KnapskaLab/Current_Protocols/README.md

# Current_Protocols
This repository contains materials necessary to conduct Imminent Threat Paradigm in both contextual and auditory-cued variants
