KnapskaLab/Current_Protocols/Cage_schematics.pdf

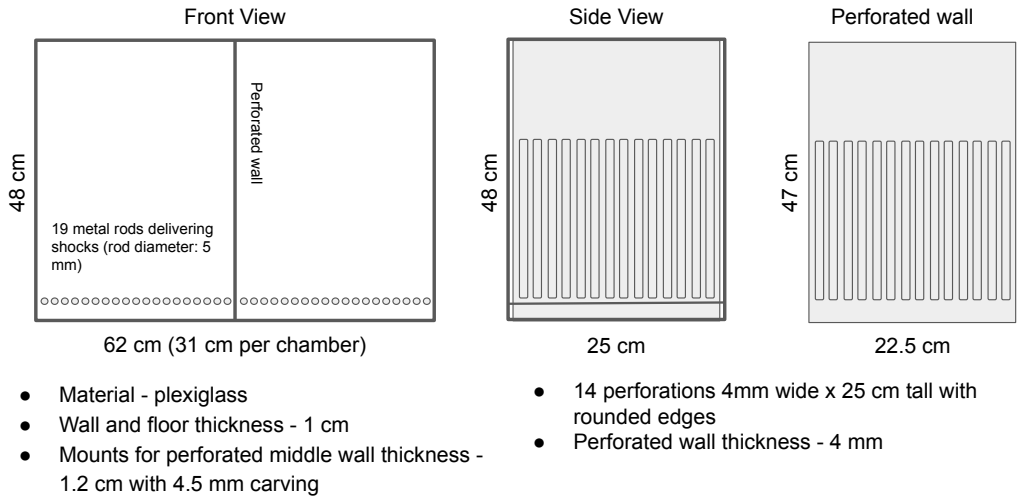
[picture p1: page 1]
Front View; Side View; Perforated wall

62 cm (31 cm per chamber) Perforated wall

19 metal rods delivering
shocks (rod diameter: 5

● Material - plexiglass
● Wall and floor thickness - 1 cm
● Mounts for perforated middle wall thickness -
1.2 cm with 4.5 mm carving

● 14 perforations 4mm wide x 25 cm tall with
rounded edges
● Perforated wall thickness - 4 mm
