KnapskaLab/Current_Protocols/PCB_Project/1_3_AURDINO_UNO.pdf

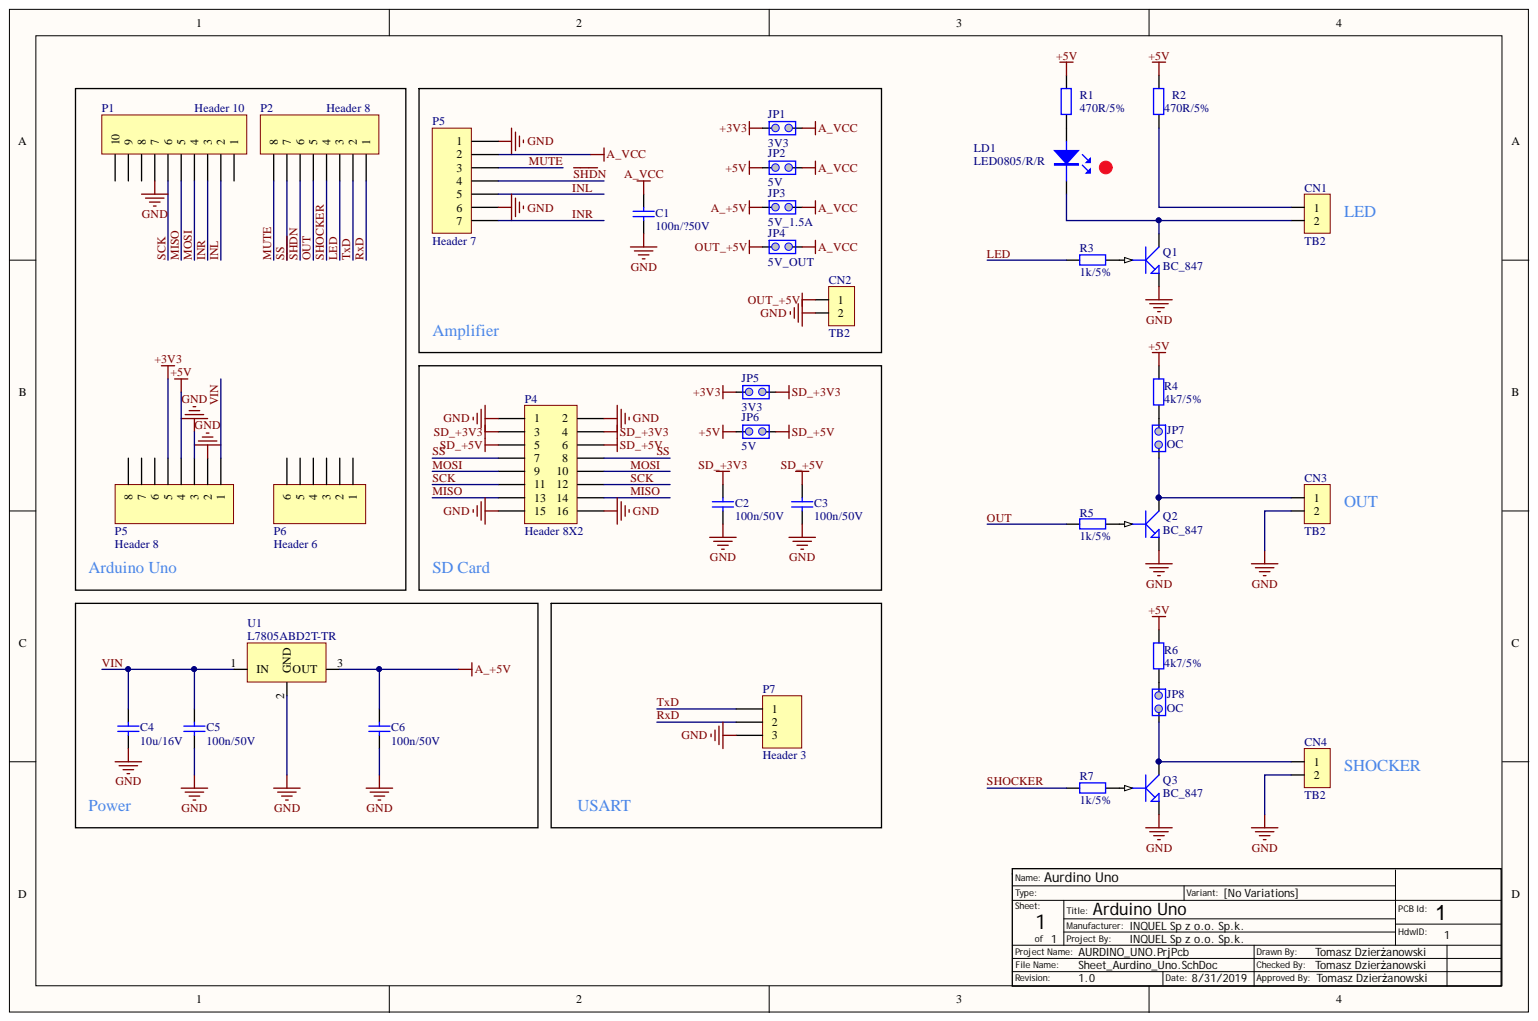
[picture p2: page 1]

T y p e : | t : [ No V ari a t ions]
Sh e e t :o 1 f 1 | PcbVarian Arduino Uno Title : | P CB Id : 1

AURDIN O _UN O . Prj Proj e c t Nam e : | Tom a sz Dz ier ż anowski Drawn By :
File Nam e : Sheet _Aurd ino_Uno. SchDoc | C h e c k e d By : Tom a sz Dz ier ż anowski
R e visio n : 1 . 0 | Dat e : 8 / 3 1 / 2 0 1 9 | A p pro v e d By : Tom a sz Dz ier ż anowski

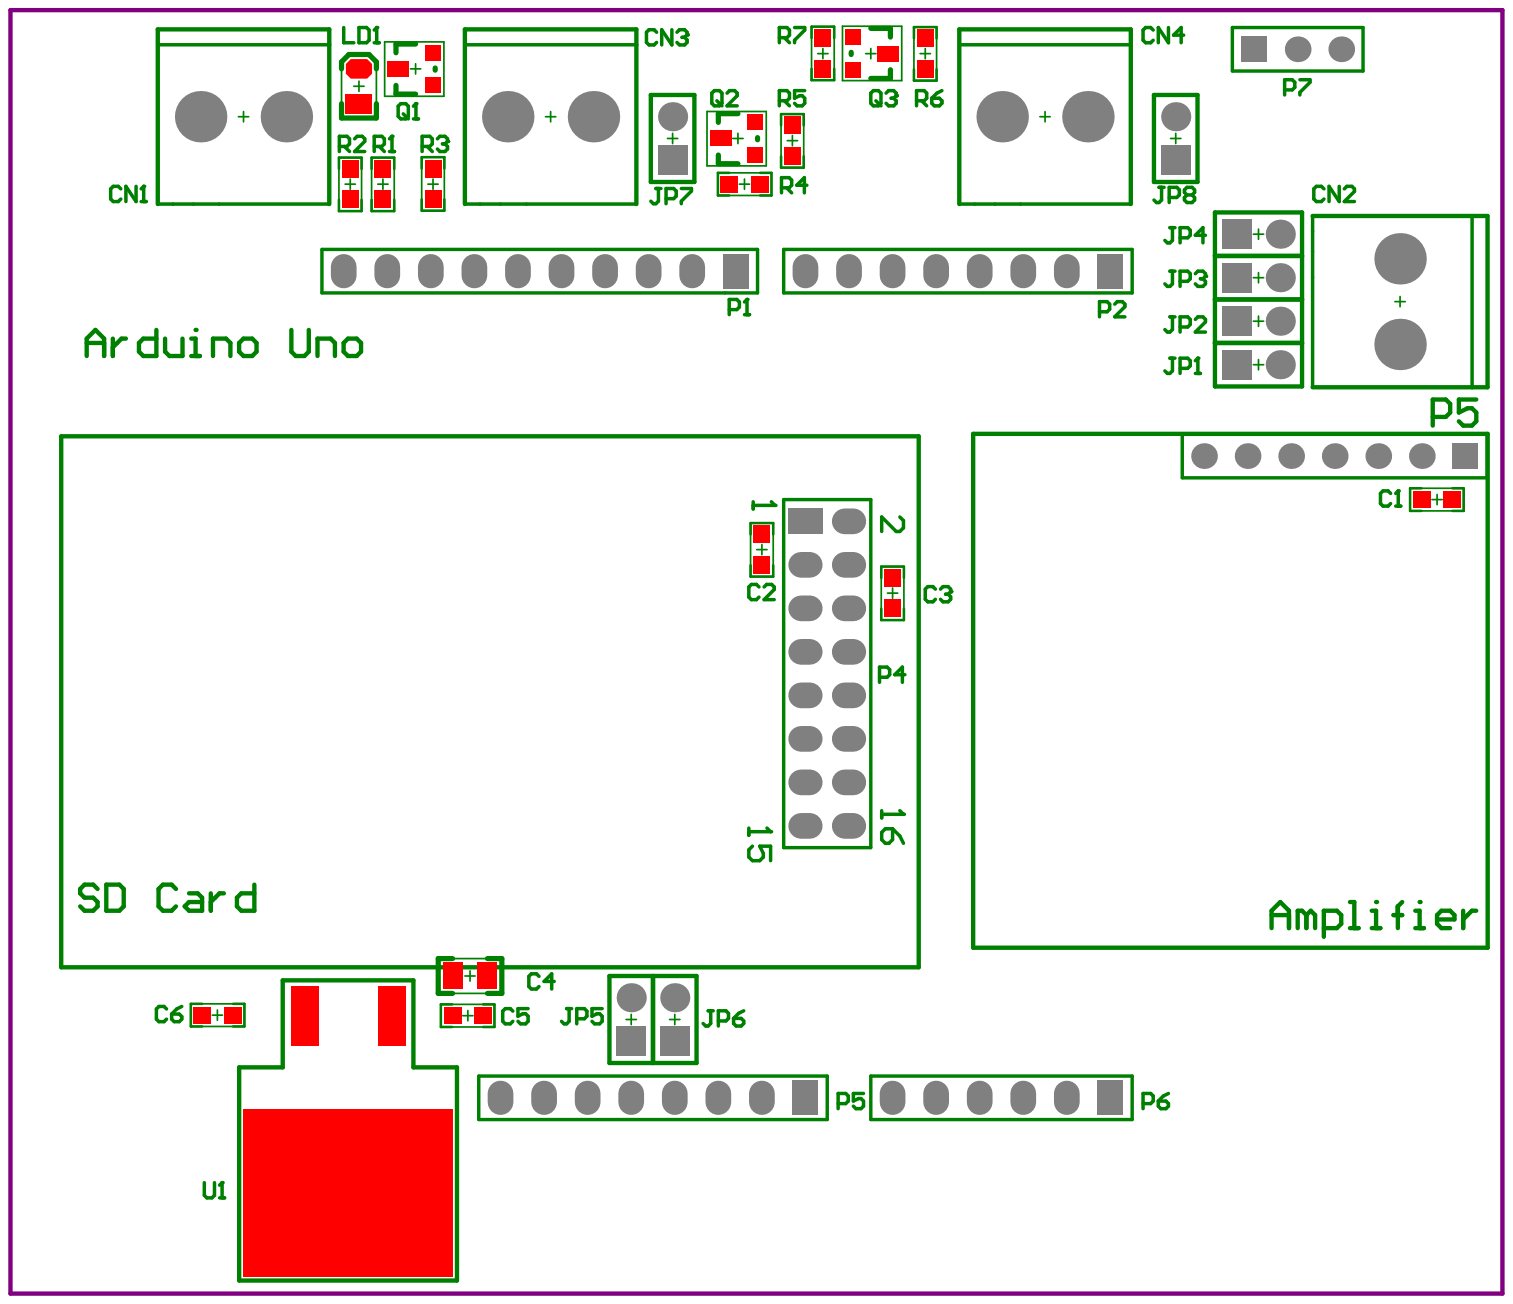
[picture p3: page 2]

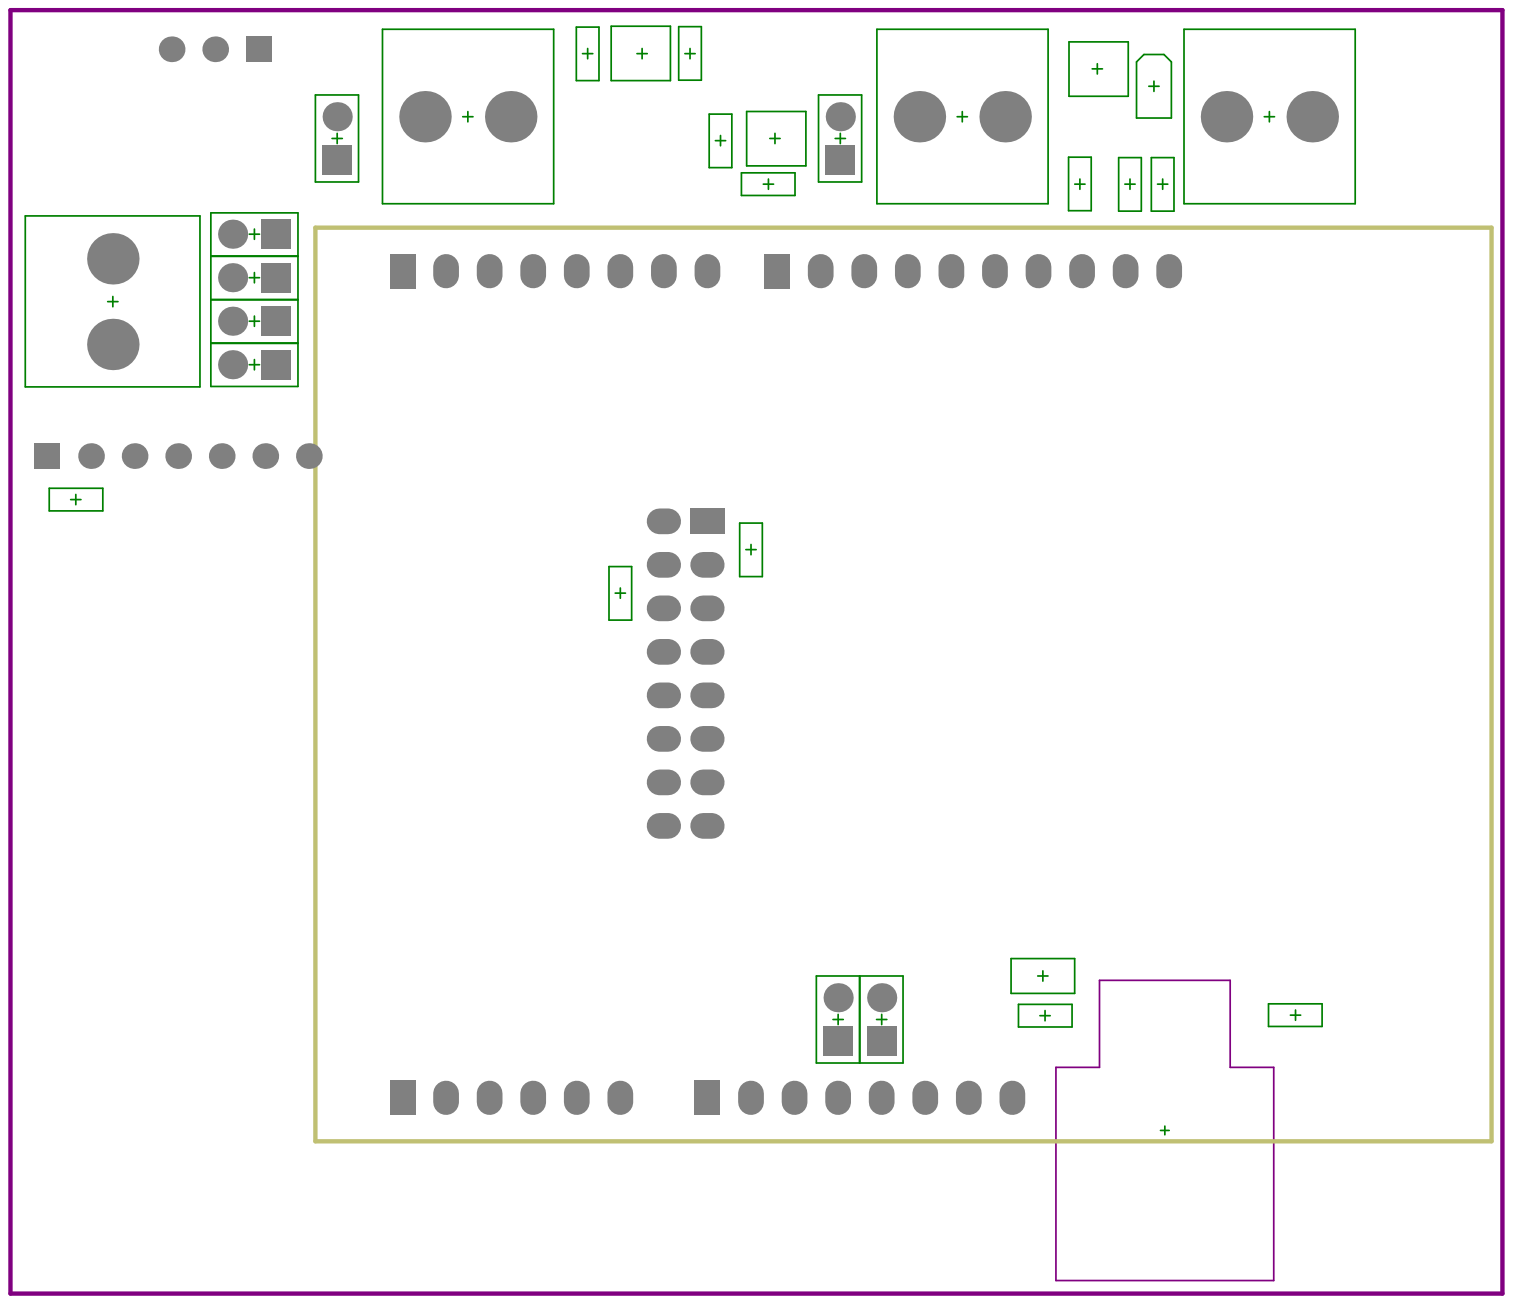
[picture p4: page 3]

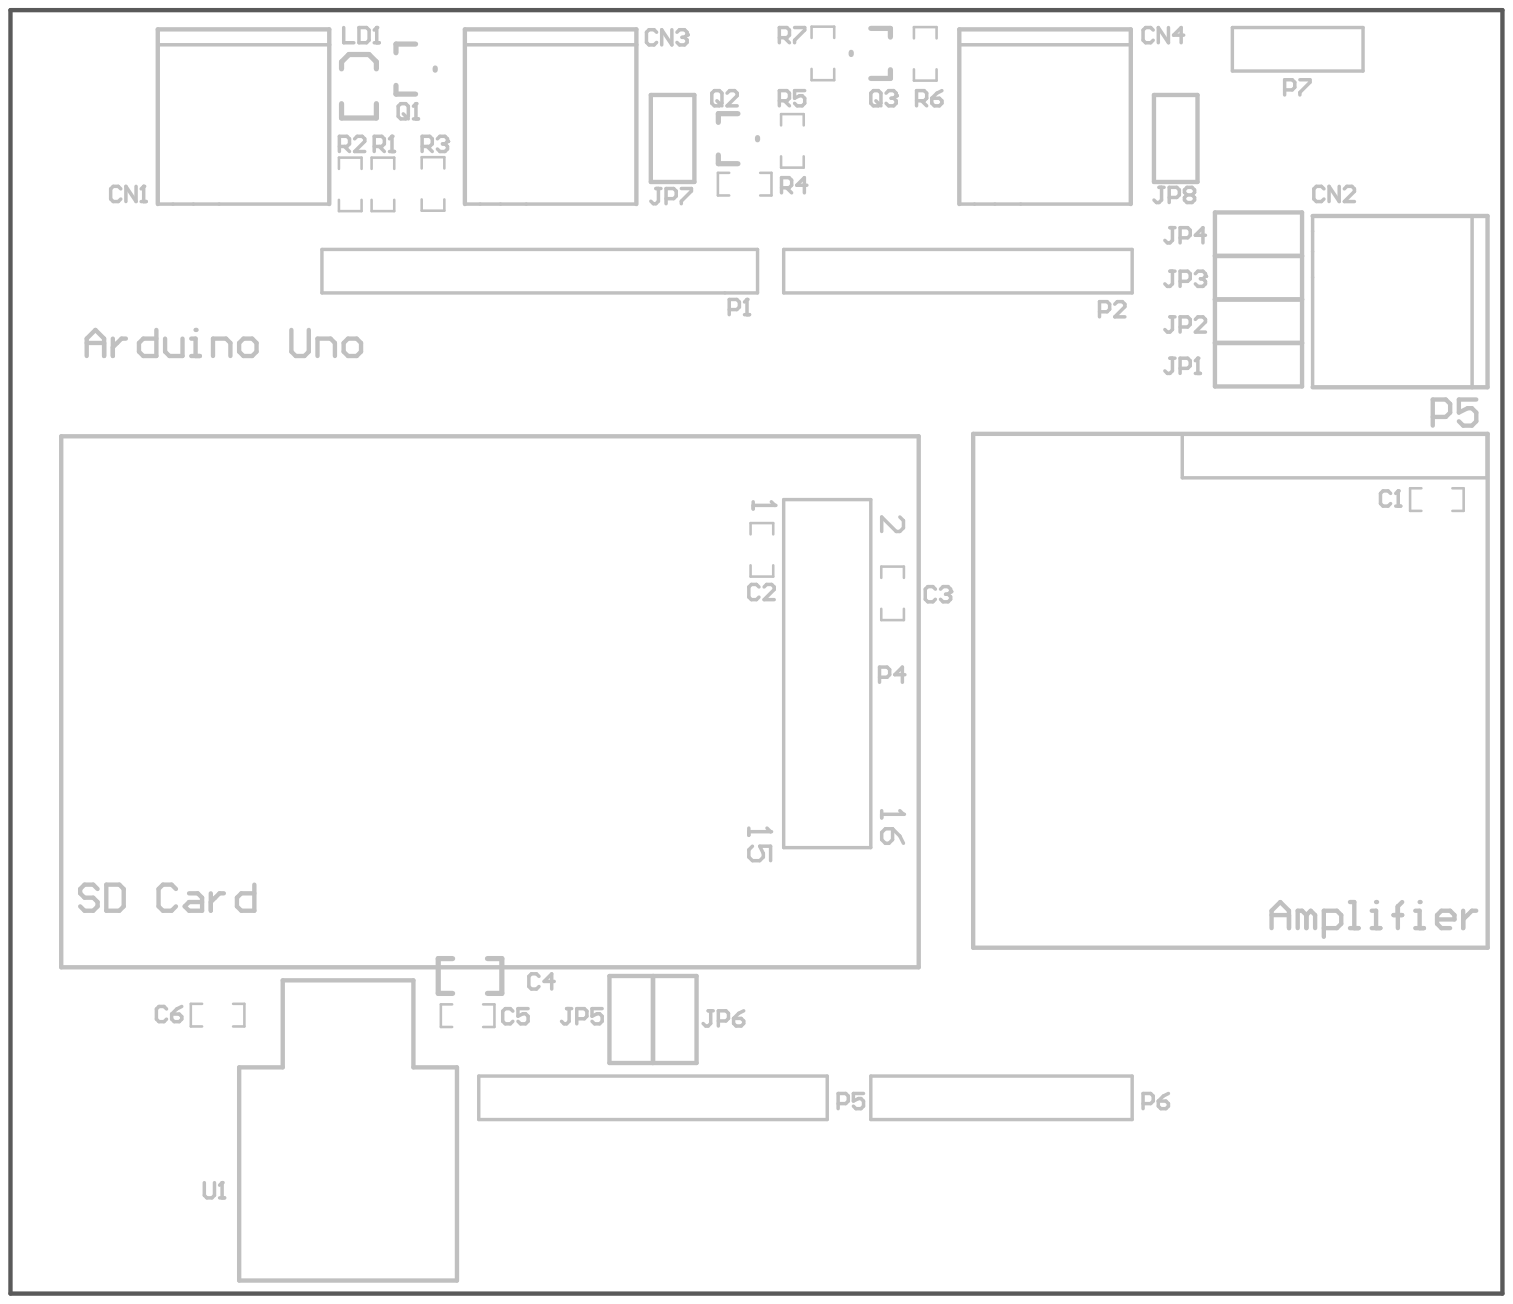
[picture p5: page 4]

## Bill of Materials For Project [AURDINO_UNO.PrjPcb] (No PCB Document Selected)

# Bill of Materials

Source Data From: | | AURDINO_UNO.PrjPcb
Project: | | AURDINO_UNO.PrjPcb
Variant: | | None
Project Revision: | | 1.0
Board Number | | 1
Hardware ID: | | 1
Creation Date: | 8/31/2019 | 11:35:02 AM
Print Date: | 8/31/2019 | 11:35:08 AM
Quantity | Comment | Designator | Footprint | Montage | Part Number | Manufacturer
1 | 100n/?50V | C1 | CC_0603 | SMD
4 | 100n/50V | C2, C3, C5, C6 | CC_0603 | SMD
1 | 10u/16V | C4 | CC_0805 | SMD
4 | TB2 | CN1, CN2, CN3, CN4 | CN_DG128-5_0-02P-14 | THT | TB2
2 | 3V3 | JP1, JP5 | JP_Jumper | THT | 3V3
2 | 5V | JP2, JP6 | JP_Jumper | THT | 5V
1 | 5V_1.5A | JP3 | JP_Jumper | THT | 5V_1.5A
1 | 5V_OUT | JP4 | JP_Jumper | THT | 5V_OUT
2 | OC | JP7, JP8 | JP_Jumper | THT | OC
1 | LED0805/R/R | LD1 | LD_0805_R | SMD | LED0805
1 | Header 10 | P1 | HDR1X10
2 | Header 8 | P2, P5 | HDR1X8
1 | Header 8X2 | P4 | HDR2X8
1 | Header 7 | P5 | HDR1X7
1 | Header 6 | P6 | HDR1X6
1 | Header 3 | P7 | HDR1X3
3 | BC_847 | Q1, Q2, Q3 | Q_SOT-23 | SMD | BC_847
2 | 470R/5% | R1, R2 | R_0603 | SMD
3 | 1k/5% | R3, R5, R7 | R_0603 | SMD
2 | 4k7/5% | R4, R6 | R_0603 | SMD
1 | L7805ABD2T-TR | U1 | U_D2PAK | SMD | L7805ABD2T-TR
